bressanmarcos/ascii-motor/pinout controle.png

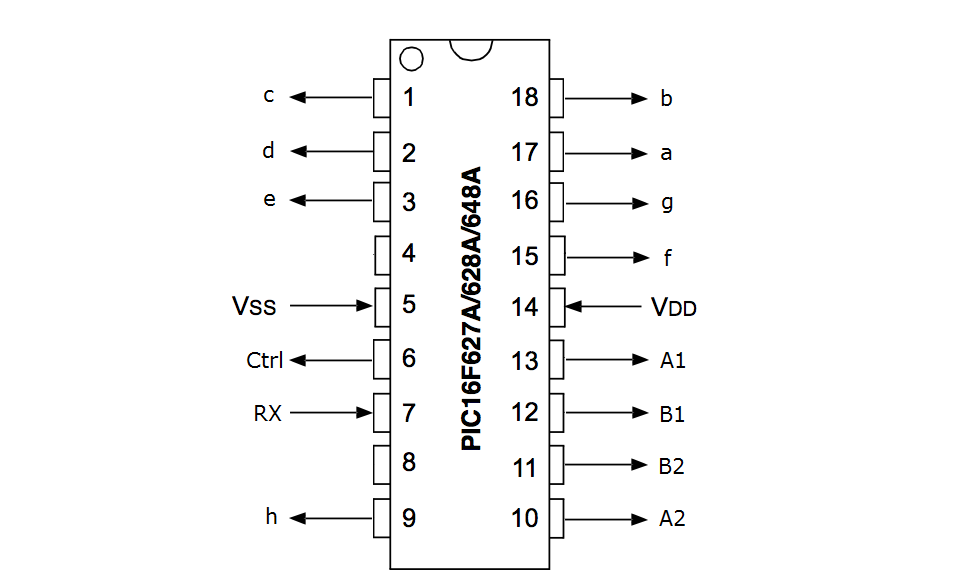
pinout controle.png
