bressanmarcos/ascii-motor/(list of files, drawings)

Other design files:
Proteus/PICdeControle.pdsprj
Proteus/PICdeDados.pdsprj
Proteus/Simulação/Simulação.pdsprj
