bressanmarcos/ascii-motor/(commit log)

2020-06-19 assembly codes
2020-06-19 Proteus project
    [PICdeControle.pdsprj, PICdeDados.pdsprj, Simulação.pdsprj]
